ErikDorstel/envObserver/(commit log)

2023-07-02 added calibration feature
2023-07-02 added calibration get option
2023-07-03 added schematic
2023-07-03 changed frequency measurement from micros() to hardware timer
2023-07-04 changed calibration defaults
2023-12-07 added relay output and static ip
2023-12-07 added relay state to getStatus
2024-03-02 added schematic source
